rtc-book/motor_board/motor_board.kicad_pcb

## KiCad design motor_board.kicad_pcb (2024-11-24)

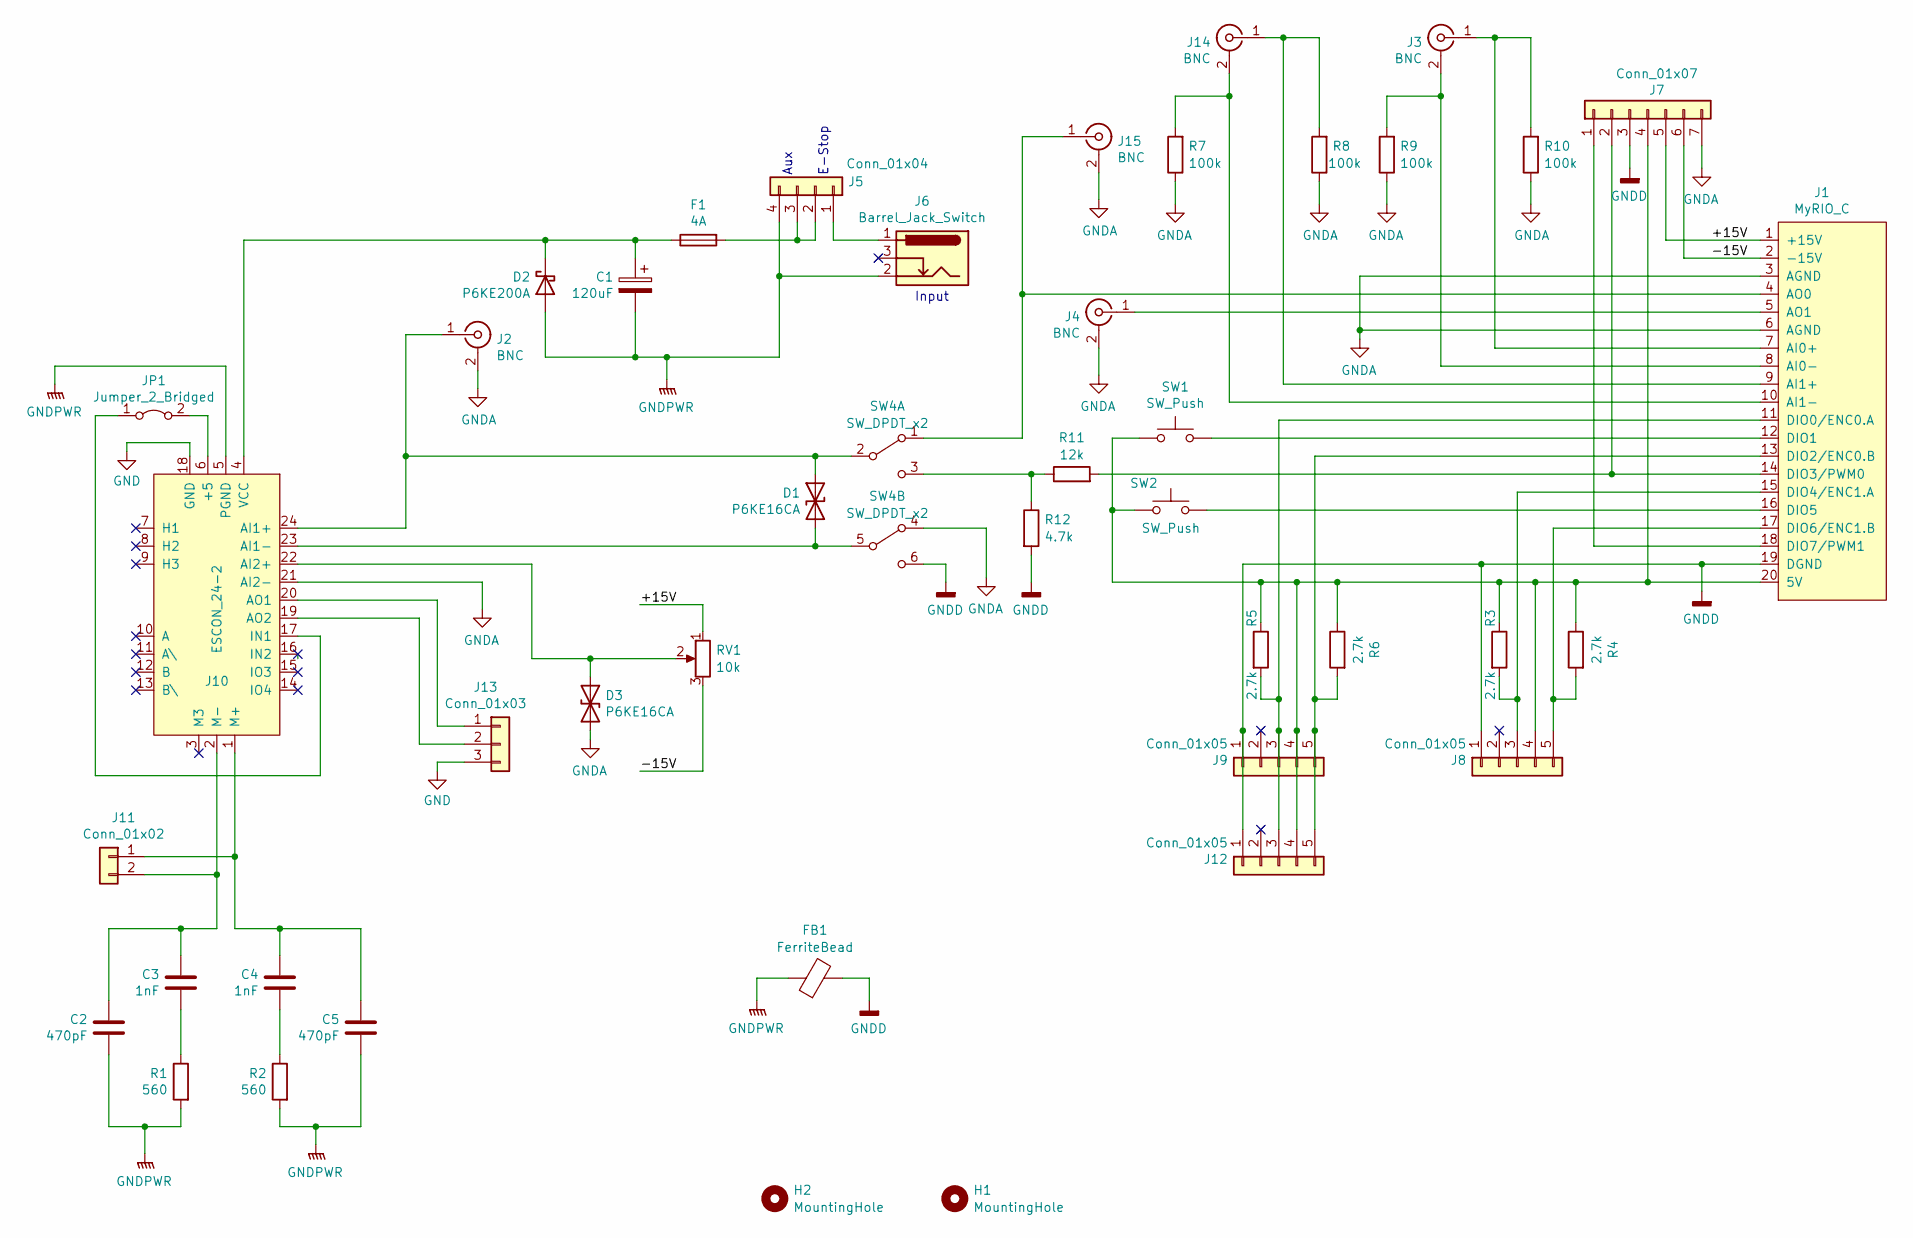
[picture p1: schematic motor_board.kicad_sch]

Parts:
C1: 120uF; CP_Radial_D8.0mm_P3.50mm; DigiKey P/N 732-8943-1-ND
C2, C5: 470pF; C_Disc_D4.3mm_W1.9mm_P5.00mm; DigiKey P/N BC2681CT-ND
C3, C4: 1nF; C_Axial_L3.8mm_D2.6mm_P7.50mm_Horizontal; DigiKey P/N 478-10987-1-ND
D1, D3: P6KE16CA; D_DO-15_P10.16mm_Horizontal; DigiKey P/N 13-P6KE16CA/B-ND
D2: P6KE200A; D_DO-15_P10.16mm_Horizontal; DigiKey P/N P6KE200ALFCT-ND
F1: 4A; Fuseholder_Cylinder-5x20mm_Schurter_0031_8201_Horizontal_Op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; DigiKey P/N 0617004.MXP-ND, 732-11376-ND
FB1: FerriteBead; L_Axial_L7.0mm_D3.3mm_P10.16mm_Horizontal_Fastron_MICC; DigiKey P/N 1934-1414-1-ND
H1, H2: MountingHole; MountingHole_#6
J1: MyRIO_C; C_Connector; DigiKey P/N ED3077-ND
J2, J3, J4, J14, J15: BNC; Vertical_BNC_Amphenol_112536; DigiKey P/N ACX1053-ND
J5: Conn_01x04; TerminalBlock_Phoenix_PT-1,5-4-5.0-H_1x04_P5.00mm_Horizontal; DigiKey P/N 102-6136-ND
J6: Barrel_Jack_Switch; BarrelJack_Horizontal; DigiKey P/N 839-54-00167-ND
J7: Conn_01x07; PinSocket_1x07_P2.54mm_Vertical; DigiKey P/N S7005-ND
J8, J9: Conn_01x05; PinHeader_1x05_P2.54mm_Vertical; DigiKey P/N 2057-PH1-05-UA-ND
J10: ESCON_24-2; DigiKey P/N S7009-ND, S7011-ND
J11: Conn_01x02; TerminalBlock_Phoenix_PT-1,5-2-5.0-H_1x02_P5.00mm_Horizontal; DigiKey P/N 102-6134-ND
J12: Conn_01x05; Encoder_and_Motor_Mount; DigiKey P/N S6103-ND
J13: Conn_01x03; PinSocket_1x03_P2.54mm_Vertical; DigiKey P/N S7036-ND
JP1: Jumper_2_Bridged; PinHeader_1x02_P2.54mm_Vertical; DigiKey P/N 2057-PH1-02-UA-ND, S9000-ND
R1, R2: 560; R_Axial_DIN0207_L6.3mm_D2.5mm_P7.62mm_Horizontal; DigiKey P/N 560WCT-ND
R3, R4, R5, R6: 2.7k; R_Axial_DIN0204_L3.6mm_D1.6mm_P5.08mm_Horizontal; DigiKey P/N CF18JT2K70CT-ND
R7, R8, R9, R10: 100k; R_Axial_DIN0204_L3.6mm_D1.6mm_P5.08mm_Horizontal; DigiKey P/N CF18JT100KCT-ND
R11: 12k; R_Axial_DIN0204_L3.6mm_D1.6mm_P5.08mm_Horizontal; DigiKey P/N 13-MFR-12FTF52-12KCT-ND
R12: 4.7k; R_Axial_DIN0204_L3.6mm_D1.6mm_P5.08mm_Horizontal; DigiKey P/N 13-MFR-12FTF52-4K7CT-ND
RV1: 10k; Potentiometer_Piher_PT-10-V10_Vertical; DigiKey P/N 1993-1116-ND
SW1, SW2: SW_Push; SW_PUSH_6mm_H5mm; DigiKey P/N CKN9093-ND
SW4: SW_DPDT_x2; TE Connectivity MHS DPDT Slide Switch; DigiKey P/N 450-1574-ND

Connections:
/+15V: J1.1 (+15V), J7.5, RV1.1
/-15V: J1.2 (-15V), J7.6, RV1.3
GND: J10.18 (GND), J13.3
GNDA: D3.2 (A2), J1.3 (AGND), J1.6 (AGND), J2.2 (Ext), J4.2 (Ext), J7.7, J10.21 (AI2-), J15.2 (Ext), R7.1, R8.1, R9.1, R10.1, SW4.4 (A)
GNDD: FB1.2, J1.19 (DGND), J7.3, J8.1, J9.1, J12.1, R12.2, SW4.6 (C)
GNDPWR: C1.2, C2.2, C5.2, D2.2 (A), FB1.1, J5.4, J6.2, J10.5 (PGND), R1.2, R2.2
unnamed: C3.2, R1.1
unnamed: C4.2, R2.1
unnamed: D1.1 (A1), J2.1 (In), J10.24 (AI1+), SW4.2 (B)
unnamed: D1.2 (A2), J10.23 (AI1-), SW4.5 (B)
unnamed: C1.1, D2.1 (K), F1.1, J10.4 (VCC)
unnamed: D3.1 (A1), J10.22 (AI2+), RV1.2
unnamed: J1.20 (5V), J7.4, J8.4, J9.4, J12.4, R3.1, R4.1, R5.1, R6.1, SW1.2, SW2.2
unnamed: J1.7 (AI0+), J3.1 (In), R10.2
unnamed: J1.8 (AI0-), J3.2 (Ext), R9.2
unnamed: J1.9 (AI1+), J14.1 (In), R8.2
unnamed: J1.10 (AI1-), J14.2 (Ext), R7.2
unnamed: J1.4 (AO0), J15.1 (In), SW4.1 (A)
unnamed: J1.5 (AO1), J4.1 (In)
unnamed: J1.11 (DIO0/ENC0.A), J9.3, J12.3, R5.2
unnamed: J1.12 (DIO1), SW1.1
unnamed: J1.13 (DIO2/ENC0.B), J9.5, J12.5, R6.2
unnamed: J1.14 (DIO3/PWM0), J7.2, R11.2
unnamed: J1.15 (DIO4/ENC1.A), J8.3, R3.2
unnamed: J1.16 (DIO5), SW2.1
unnamed: J1.17 (DIO6/ENC1.B), J8.5, R4.2
unnamed: J1.18 (DIO7/PWM1), J7.1
unnamed: J5.1, J6.1
unnamed: F1.2, J5.2, J5.3
unnamed: J10.6 (+5), JP1.2 (B)
unnamed: J10.20 (AO1), J13.1
unnamed: J10.19 (AO2), J13.2
unnamed: J10.17 (IN1), JP1.1 (A)
unnamed: C4.1, C5.1, J10.1 (M+), J11.1
unnamed: C2.1, C3.1, J10.2 (M-), J11.2
unnamed: R11.1, R12.1, SW4.3 (C)

Notes on the sheet:
Aux
Input
E-Stop

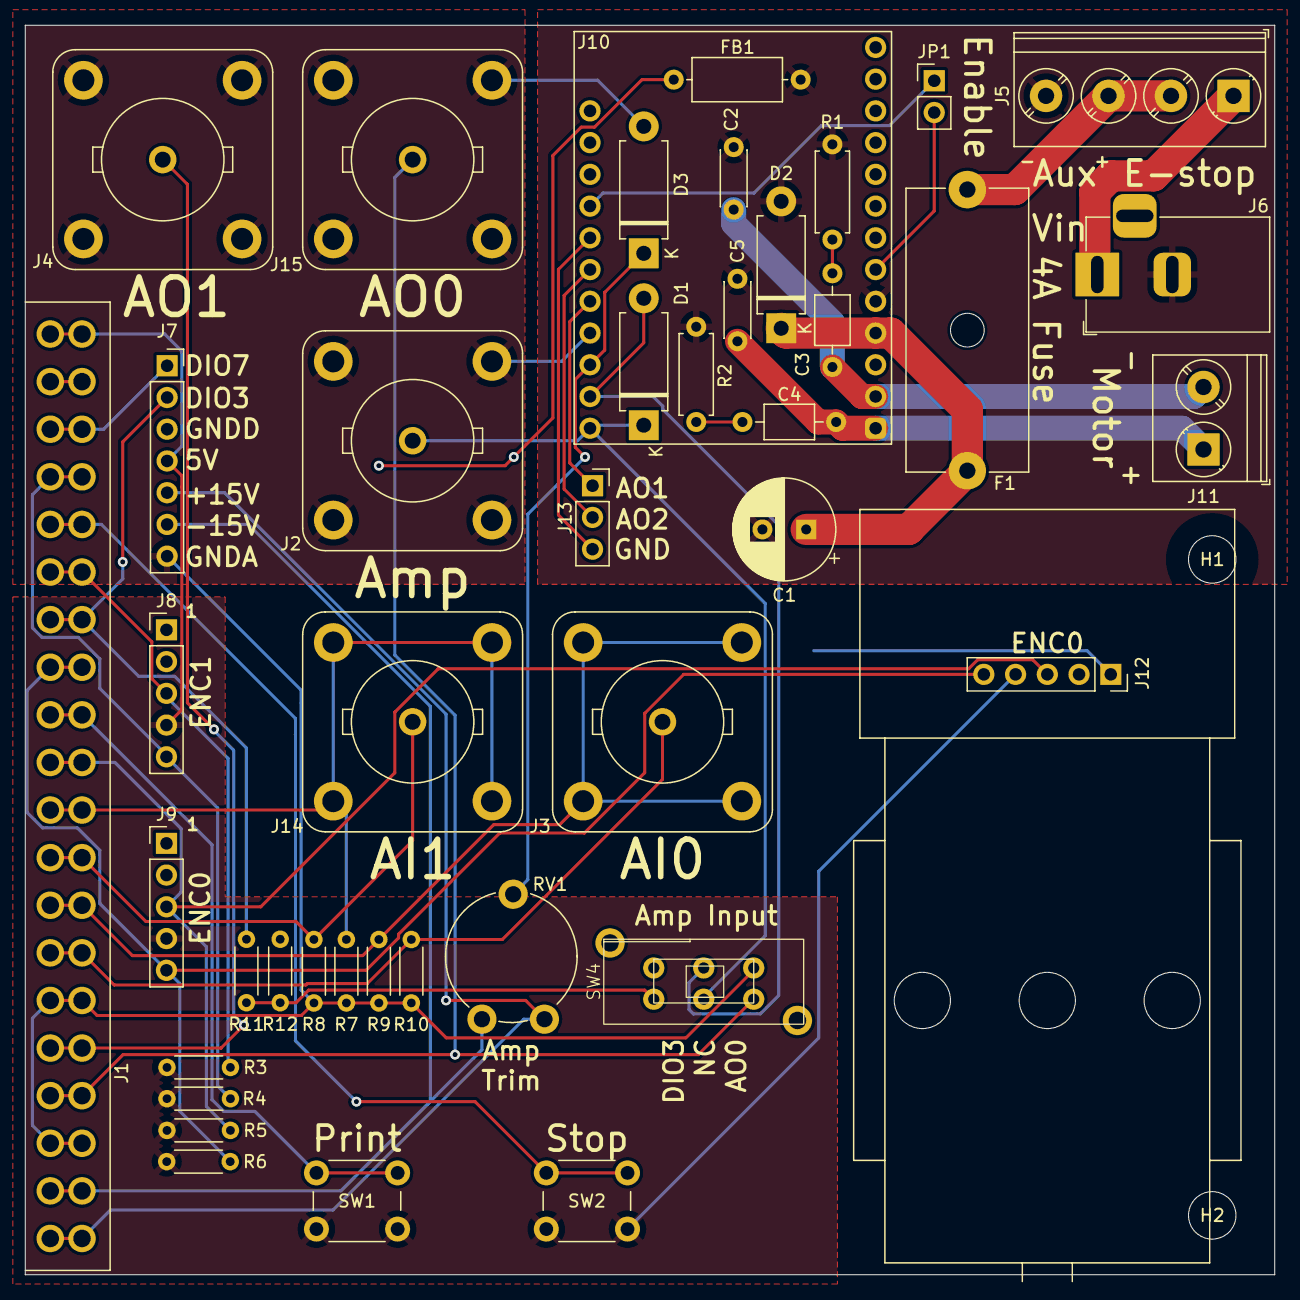
[picture p2: board motor_board.kicad_pcb from above]

Board: 2 copper layers, 100.0 x 100.0 mm, 44 parts (0 on the bottom side), 36 nets.
