rtc-book/motor_board/(threads)

Thread 2 (2025-02-21):

Select new trim pot

CameronDevine, 2025-02-21:
The currently used trim pot has the +/-15 V terminals on the top, and it is easy to short them using a screwdriver. It would be a good idea to select a new trim pot for future versions.
