rtc-book/motor_board/(commit log)

2022-11-16 removed the voltage regulator and shrunk the board
    [motor_board.kicad_pcb, motor_board.sch]
2022-11-16 removed the regulator design script since I removed the regulator
2022-11-16 added files for manufacturing
    [parts_list_DigiKey.csv]
2022-12-23 changed the switch labels and moved some things around
    [motor_board.kicad_pcb]
2022-12-24 added TVS diodes for safety
    [motor_board.kicad_pcb, motor_board.sch]
2023-04-30 twisted the motor and added a couple connectors
    [motor_board.kicad_pcb, motor_board.sch]
2023-04-30 renumbered components
    [motor_board.kicad_pcb, motor_board.sch]
2023-04-30 changed date
    [motor_board.kicad_pcb]
2023-05-02 change test points to pin sockets
    [motor_board.kicad_pcb, motor_board.sch]
2023-07-05 the first version produced
    [motor_board.kicad_pcb, motor_board.sch]
2023-09-17 board v1.1
    [motor_board.kicad_pcb, motor_board.kicad_sch, motor_board.sch]
2023-09-17 removing files because I upgraded KiCAD
    [motor_board.sch]
2023-09-30 fixed the motor label polarity issue
    [motor_board.kicad_pcb]
2023-12-12 added a couple mounting holes and updated the motor mount
    [motor_board.kicad_pcb, motor_board.kicad_sch]
2024-02-13 changed to a bidirectional TVS diode for protection on the amp analog inputs
    [motor_board.kicad_sch]
2024-08-09 updated the board with a 90 degree twisted motor and 5 bncs plus amp input switch and trim.
    [motor_board.kicad_pcb, motor_board.kicad_sch]
2024-08-12 got the motor rotated back 90 degrees to its original orientation
    [motor_board.kicad_pcb]
2024-08-12 adding v2 gerbers
2024-08-13 removing digikey partslist because it is out of date
    [parts_list_DigiKey.csv]
2024-08-23 added a resistor divider to the PWM amp input
    [motor_board.kicad_pcb, motor_board.kicad_sch]
2024-10-16 updated the board to use a 10k pot that is hopefully more heat resistant and has longer leads.
    [motor_board.kicad_pcb, motor_board.kicad_sch]
2024-11-04 Adding the design notebook of the updated resistor divider
2024-11-11 added a resistor divider to get the correct current for lab 4, added DIO3 to the aux header, and changed to a more durable 10 k put to keep from overloading the +/-15 V supply.
    [motor_board.kicad_pcb, motor_board.kicad_sch]
2024-11-24 The final design
    [motor_board.csv, motor_board.kicad_pcb, motor_board.kicad_sch]
